mariofritzer/CellDoc/docs/hardware.md

# CellDoc – Hardware

Schaltung, Pinbelegung und Einkaufsliste. Aufbau auf Lochraster oder eigener Platine, **nicht auf dem Steckbrett** (bis 8 A).

| Eckdaten | |
|---|---|
| Last | max. 30 W, max. 8 A (Anschluss A max. 5 A) |
| Packs | bis 6S / 25,2 V, Einzelzellen über Balancer |
| Laden | nur 1S an Anschluss A, 1 A, Li-Ion/LiPo (4,2 V) oder LiFePO4 (3,6 V) |
| Versorgung | 12 V / 3 A |

## Schaltplan

Schaltplan

Erzeugt mit `python3 tools/wiring_gen.py docs/img/schaltplan.svg`. Netzlabel mit gleichem Namen sind verbunden, dicke Linien führen Akku- und Laststrom.

## Aufbau

<picture>
  <source media="(prefers-color-scheme: dark)" srcset="img/aufbau-dark.jpg">
  3D-Ansicht des Aufbaus
</picture>

## Anschlussplan

<picture>
  <source media="(prefers-color-scheme: dark)" srcset="img/anschlussplan-dark.jpg">
  Anschlussplan in der Draufsicht
</picture>

Die Bilder entstehen aus `tools/render/scene.py` (Blender) und `tools/render/compose.py`. Die Anordnung ist ein Vorschlag, die Kabelfarben gelten für die ganze Doku:

| Farbe | Leitung |
|---|---|
| Rot | 12 V |
| Rosa | 5 V |
| Schwarz | Masse |
| Orange (dick) | Akku- und Laststrom |
| Grün (dick) | Ladestrom TP5000 → K1 |
| Blau / Gelb | I²C SDA / SCL |
| Türkis | 1-Wire zu den DS18B20 |
| Lila | Steuersignale (Relais, Lader, Last, Lüfter) |
| Grau | Balancer-Abgriffe |

## Blockschaltbild

<picture>
  <source media="(prefers-color-scheme: dark)" srcset="img/blockschaltbild-dark.png">
  Blockschaltbild von CellDoc
</picture>

Zelle A und Pack B haben getrennte Sicherungen und Strommesser. K2 schaltet die Last auf genau einen Anschluss. Der Lader ist fest nur mit Anschluss A verdrahtet und kann ein Pack daher nie erreichen. Alle Minuspole treffen sich an einem Masse-Sternpunkt.

## Stromversorgung über USB-C

Alle Varianten bekommen ihren Strom über ein **USB-C-PD-Decoy-Modul** („PD/QC/AFC fast charge decoy trigger“). Es handelt mit dem Netzteil eine feste Spannung aus, eingestellt mit drei kleinen Schaltern auf der Rückseite:

| Spannung | S1 | S2 | S3 |
|---|:---:|:---:|:---:|
| 5 V | 0 | 0 | 0 |
| 9 V | 1 | 0 | 0 |
| **12 V** | **1** | **1** | **0** |
| 15 V | 0 | 1 | 0 |
| 20 V | 0 | 1 | 1 |

Die Tabelle steht auch auf der Platine. Es gibt Module mit anderer Belegung, im Zweifel gilt der Aufdruck. Das Modul liefert höchstens 3 A. Vor dem ersten Anschließen die Spannung am Ausgang mit dem Multimeter prüfen.

**CellDoc:** Decoy auf **12 V** (S1 S2 S3 = 1 1 0). Die 12 V versorgen Lüfter und LM358 direkt, der LM2596 macht daraus 5 V für ESP32, TP5000, Relais und Summer. Gebraucht werden nur etwa 10–15 W, die Entladeleistung kommt aus dem Akku. Wichtig: Das Netzteil muss **12 V** können. Viele Laptop-Netzteile liefern nur 5, 9, 15 und 20 V, das steht klein auf dem Netzteil (z. B. „12V⎓2.5A“).

## Leistungspfad

| Von | Nach | Hinweis |
|---|---|---|
| Zelle A + | F1 (7,5 A Flachsicherung) | 18650-Halter, Schraubklemme und Lötpads parallel |
| nach F1 | D1 Kathode, Anode an GND | Verpolschutz: bei falsch gepolter Zelle leitet D1 und F1 löst aus |
| nach F1 | INA226 A IN+ → Shunt → IN− = Knoten A | Shunt 10 mΩ statt des 100 mΩ auf dem Modul |
| Zellpol + (eigene Leitung) | INA226 A VBUS | Fühlerleitung direkt am Pol, damit Kabelverluste nicht in den Innenwiderstand eingehen |
| Knoten A | K2 NC | Ruhezustand: Last an Zelle A |
| TP5000 BAT+ | K1 → Knoten A | Ladestrom läuft durch INA226 A und wird mitgezählt |
| Pack B + (XT60) | F2 (10 A) → D2 → INA226 B → Knoten B | Aufbau wie A, VBUS ebenfalls per Fühlerleitung |
| Knoten B | K2 NO | Nur bei aktivem Packtest |
| K2 COM | Last+ (beide Drains) | Silikonkabel 1,5 mm² |
| Zelle A −, Pack B −, Last-GND | Masse-Sternpunkt | auch ESP32-, INA226- und ADS1115-GND |

## Konstantstromlast

Zwei gleiche Kanäle mit je 15 W. Beide bekommen denselben Sollwert und teilen sich den Strom. Die Firmware regelt den Sollwert mit dem INA226 nach, Bauteiltoleranzen gehen deshalb nicht ins Ergebnis ein.

**Sollwert**

| Bauteil | Anschluss | Verbindung |
|---|---|---|
| MCP4725 | VOUT | 7,5 kΩ → Knoten SOLL → 1 kΩ → GND (0–3,3 V → 0–0,39 V) |
| Q3 BSS138 | D an SOLL, S an GND | Gate an FREIGABE |
| FREIGABE | 10 kΩ nach 3,3 V | ESP32 GPIO 16 zieht LOW = Last frei. Beim Booten oder Absturz ist die Last automatisch aus |

**Je Kanal (zweimal aufbauen)**

| Bauteil | Anschluss | Verbindung |
|---|---|---|
| LM358 (12 V) | IN+ | Knoten SOLL |
| LM358 | IN− | 10 kΩ zum Knoten SENSE, 10 nF von OUT nach IN− |
| LM358 | OUT | 1 kΩ → Gate IRFP250N |
| IRFP250N | Drain | Last+ (K2 COM) |
| IRFP250N | Source | Knoten SENSE → 0,1 Ω / 5 W → GND |
| Q4/Q5 BSS138 | D an Gate, S an GND | Gate an FREIGABE, zieht den MOSFET hart aus |
| Gate | 10 kΩ nach GND | Pull-down |

Beide IRFP250N isoliert (Drain liegt am Gehäuse) auf einen CPU-Kühler mit 4-Pin-Lüfter schrauben. DS18B20 T3 mit Wärmeleitkleber zwischen die MOSFETs.

**Temperaturfühler DS18B20: TO-92 oder wasserdicht, nach Wahl.**
- **TO-92 (empfohlen, vor allem an der Zelle):** reagiert schneller und liegt mit der flachen Seite gut an der Zelle an. Am besten fest in den Zellenhalter kleben (Wärmeleitkleber oder Kaptonband), so dass die eingesetzte Zelle darauf liegt. Beinchen mit Schrumpfschlauch isolieren, der Zellmantel ist Minus.
- **Wasserdicht (Edelstahlhülse mit Kabel):** robuster und fertig verkabelt, aber träger. Gut für den Kühlkörper, an der Zelle weniger.
- Beide Bauformen sind elektrisch gleich (rot = 3,3 V, schwarz/gelb je nach Hersteller = GND/Daten, im Zweifel nachmessen). Die Firmware erkennt beide.

## Lader TP5000

Der CS-Pin wählt die Ladeschlussspannung: **hoch = 4,2 V**, **offen = 3,6 V**, **auf Masse = aus**. Bei Modulen mit 3,6-V-Lötbrücke diese öffnen, damit der ESP32 den Pin steuern kann.

| Modulpin | Verbindung | Zweck |
|---|---|---|
| VIN / GND | 5 V vom Step-Down | Versorgung |
| CS | P-MOSFET AO3401 nach 5 V, über NPN von GPIO 32 | 4,2 V |
| CS | N-MOSFET AO3400 nach GND, Gate an GPIO 33 (10 kΩ Pull-down) | Stopp und Drosselung im Takt |
| CS | beide aus | 3,6 V (LiFePO4), Zustand beim Booten |
| CHRG / STDBY | je 1 kΩ zu GPIO 34 / 35, 10 kΩ Pull-up nach 3,3 V | lädt / voll |
| Rs | 0,1 Ω (Standard) | 1 A Ladestrom |
| TS | an GND | interne Temperaturüberwachung aus, das übernimmt T1 |
| BAT+ | K1 (Schließer) → Knoten A | Lader nur verbunden, wenn K1 anzieht |

## Balancer

Jeder Abgriff des JST-XH-Steckers bekommt einen Teiler 100 kΩ / 10 kΩ (0,1 %). Abgriff 1–4 an ADS1115 Nr. 1 (0x48, ADDR an GND), Abgriff 5–6 an ADS1115 Nr. 2 (0x49, ADDR an VDD). Einmal mit dem Multimeter kalibrieren (Einstellungen → Kalibrierung).

## Temperatur, Lüfter, Summer

| Teil | Verbindung | Hinweis |
|---|---|---|
| 3× DS18B20 | parallel an GPIO 4, 4,7 kΩ nach 3,3 V | T1 Zelle A, T2 Pack, T3 Kühlkörper |
| Lüfter PWM | AO3400 Drain an PWM-Pin, Gate an GPIO 25 | 25 kHz |
| Lüfter TACH | GPIO 39, 10 kΩ nach 3,3 V | Lüfterausfall schaltet die Last ab |
| Summer | aktiver 5-V-Summer über AO3400 an GPIO 17 | Alarm und „fertig“ |

## ESP32-Pinbelegung

| GPIO | Funktion |
|---|---|
| 21 / 22 | I²C SDA / SCL (INA226 ×2, MCP4725, ADS1115 ×2), 4,7 kΩ Pull-ups |
| 4 | 1-Wire DS18B20 ×3 |
| 16 | Last-Freigabe (LOW = frei) |
| 26 | K1 Laderelais |
| 27 | K2 Lastumschaltung A/B |
| 32 | TP5000 CS hoch (4,2 V) |
| 33 | TP5000 CS auf Masse (Stopp) |
| 34 / 35 | TP5000 CHRG / STDBY |
| 25 | Lüfter PWM |
| 39 | Lüfter Drehzahl |
| 17 | Summer |
| 19 / 18 | QR-Scanner TX / RX (optional) |
| 13 / 14 / 23 | Taster ◀ / OK / ▶ (optional, gegen GND) |
| 0 | BOOT-Taste = Not-Aus |

Relaismodule mit Jumper auf **High Level Trigger**, dann bleiben die Relais beim Booten aus.

### Variante mit ESP32-S3

Statt des ESP32 DevKit V1 geht auch ein **ESP32-S3-DevKitC-1 N16R8** (16 MB Flash, 8 MB PSRAM, zwei USB-C-Buchsen). Vorteile: rund 10 MB Speicher für Bestand und Kurven statt 896 KB, mehr Reserve, und die RGB-LED auf dem Board zeigt den Zustand (grün bereit, türkis lädt, orange entlädt, rot blinkend Fehler, blau blinkend Hotspot). Die Pinbelegung ist eine andere, alles Übrige bleibt gleich. Der Webflasher erkennt den S3 selbst; für Updates über die Weboberfläche die Dateien mit `-s3` im Namen nehmen.

- Nicht belegen: IO35–37 (gehören zum PSRAM), IO19/20 (USB), IO0/3/45/46 (Boot-Pins).
- Zum Flashen die USB-C-Buchse mit der Aufschrift **COM** (bzw. UART) nehmen, die zweite (USB) geht auch.

Schaltplan mit ESP32-S3

| Funktion | ESP32 | ESP32-S3 |
|---|---|---|
| I²C SDA / SCL | 21 / 22 | 8 / 9 |
| 1-Wire DS18B20 | 4 | 4 |
| Last-Freigabe | 16 | 5 |
| K1 / K2 | 26 / 27 | 6 / 7 |
| TP5000 CS hoch / Masse | 32 / 33 | 15 / 16 |
| TP5000 CHRG / STDBY | 34 / 35 | 17 / 18 |
| Lüfter PWM / Drehzahl | 25 / 39 | 10 / 11 |
| Summer | 17 | 12 |
| QR-Scanner TX / RX | 19 / 18 | 13 / 14 |
| Taster ◀ / OK / ▶ | 13 / 14 / 23 | 1 / 2 / 42 |
| BOOT = Not-Aus | 0 | 0 |
| RGB-LED auf dem Board | – | 48 |

## Display und Taster (optional)

Wie bei der Mini lässt sich ein **OLED SH1106 1,3"** (I²C, Adresse 0x3C) mit drei Tastern anschließen. Das Display hängt mit an SDA/SCL, die Taster schalten gegen GND (interne Pull-ups, keine Widerstände nötig). Ohne Display läuft alles wie bisher, die Firmware erkennt es beim Start.

| Taste | Wirkung |
|---|---|
| ◀ / ▶ | Seiten: Live, Temperaturen, Balancer, Netzwerk (mit IP-Adresse) |
| OK | Ergebnis oder Fehler bestätigen; auf „Live“ ohne Vorgang: Standardtest an Anschluss A (gescannte oder neue Zelle, 0,5 A, danach Lagerspannung) |
| OK lang | laufenden Vorgang stoppen |

Nach einem Test steht die Zellnummer groß mit Kapazität, Note und Lebenszahl auf dem Display, zum Übertragen aufs Etikett.

## QR-Scanner (optional)

Ein fertiges Scanner-Modul liest die Etiketten direkt am Gerät. Es dekodiert den QR-Code selbst und schickt nur den Text über die serielle Schnittstelle (9600 Baud) an den ESP32.

| Scanner | ESP32 |
|---|---|
| VCC | 3V3 |
| GND | GND |
| TX | IO19 |
| RX | IO18 |

- Empfehlung: **GM861S** (3,3 V Versorgung und Pegel, ca. 15–20 €). Ein **GM65** geht auch, braucht aber 5 V Versorgung. Dann den TX des Scanners über einen Pegelwandler an IO19 legen.
- Den Scanner einmal auf **Induktionsmodus** (Sensing Mode) stellen. Dazu den passenden Einstell-Code aus seinem Handbuch scannen. Dann liest er automatisch, sobald ein Etikett davor gehalten wird.
- Die Firmware erkennt den Scanner von selbst. Unter Einstellungen → Diagnose steht dann „QR-Scanner: ok“.

**Ablauf:** Zelle mit dem Etikett vor den Scanner halten, es piept kurz. Ein langer Ton bedeutet, dass der Code unbekannt ist. Die gescannte Zelle ist danach 10 Minuten lang im Startdialog vorausgewählt. Ist die Seite „Bestand“ offen, öffnet sich die Zelle dort.

## Einkaufsliste

| Menge | Teil | Wofür |
|---|---|---|
| 1 | ESP32 DevKit V1 (WROOM-32, 30 Pin) | Steuerung |
| 2 | INA226-Modul + 2× Shunt 10 mΩ (2512, 1 %) | Strom und Spannung A/B |
| 1 | MCP4725-Modul | Sollwert Last |
| 2 | ADS1115-Modul | Balancer bis 6S |
| 1 | TP5000-Modul (4,2 V / 3,6 V) | Lader 1S |
| 1 | 2-Kanal-Relaismodul 5 V, 10 A, mit High/Low-Jumper | K1, K2 |
| 2 | IRFP250N + isolierende Wärmeleitpads | Last |
| 2 | Widerstand 0,1 Ω / 5 W | Messwiderstand Last |
| 1 | LM358 + Sockel | Regler Last |
| 1 | CPU-Kühler mit 4-Pin-Lüfter 12 V | Kühlung |
| 3 | DS18B20, TO-92 oder wasserdicht (nach Wahl) | T1–T3 |
| – | 3× BSS138, 4× AO3400, 1× AO3401, 1× BC547 | Schalter |
| 1 | Aktiver Summer 5 V | Alarm |
| 1 | Step-Down LM2596 (auf 5,0 V einstellen) | 5-V-Versorgung |
| 1 | USB-C-PD-Decoy-Modul (5/9/12/15/20 V), auf 12 V gestellt | Versorgung |
| 1 | USB-C-Netzteil mit 12 V, ab 20 W | Versorgung |
| 3 | Flachsicherungshalter + Sicherungen 3 / 7,5 / 10 A | F0–F2 |
| 2 | Schottky 15SQ045 | Verpolschutz |
| 1 | 18650-Halter, Schraubklemme ≥ 10 A | Anschluss A |
| 1 | XT60-Buchse, JST-XH 2S–6S oder Balancer-Adapter | Anschluss B |
| – | Widerstände 12× 100 kΩ + 12× 10 kΩ (0,1 %), 7,5 kΩ, 1 kΩ, 10 kΩ, 4,7 kΩ; 10 nF, 100 nF | |
| – | Lochraster, Silikonkabel 1,5 mm² und 0,25 mm² | Aufbau |
| (1) | QR-Scanner GM861S, 3,3 V (optional) | U15 |
| (1) | OLED SH1106 1,3" I²C + 3 Taster (optional) | U16, SW1–3 |

## Aufbau und erste Inbetriebnahme

1. Starkstromwege mit Drahtbrücken oder 1,5-mm²-Kabel, nicht über dünne Lochraster-Leiterbahnen.
2. Masse als Stern, damit Laststrom nicht durch die Messmasse fließt.
3. VBUS-Fühlerleitungen getrennt direkt an den Akkupol.
4. Ohne Akku einschalten, Step-Down auf 5,0 V stellen, flashen, unter Einstellungen → Diagnose alle I²C-Geräte prüfen.
5. Last zuerst mit einer günstigen Zelle bei 0,2 A testen.

> **Sicherheit:** LiPo-Packs nur auf nicht brennbarer Unterlage testen und den Prüfstand bei hohen Strömen nicht unbeaufsichtigt lassen, auch wenn die Firmware abschaltet.
