mariofritzer/CellDoc/docs/img/anschlussplan-dark.jpg

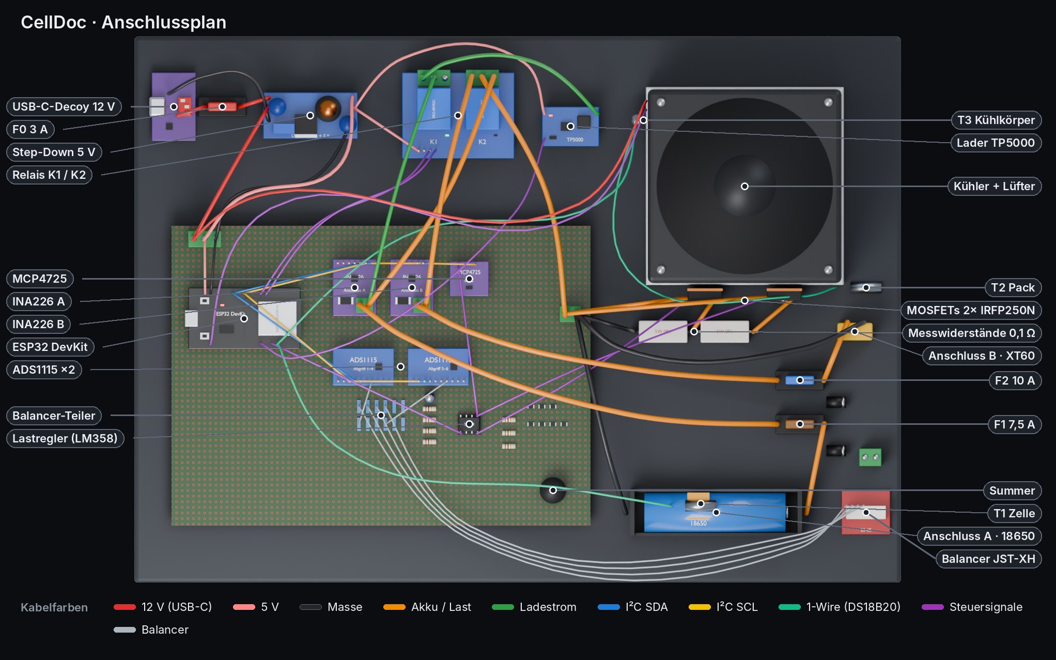
docs/img/anschlussplan-dark.jpg
