mariofritzer/CellDoc/docs/img/blockschaltbild-dark.png

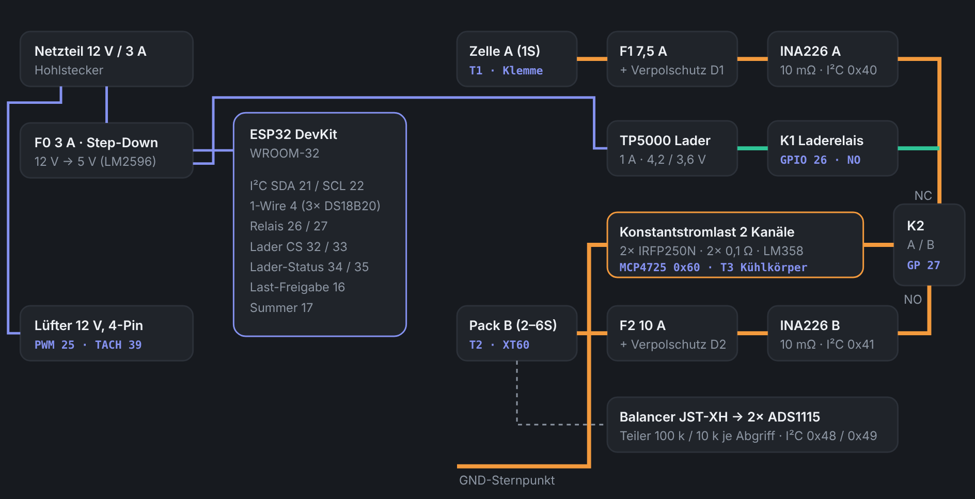
docs/img/blockschaltbild-dark.png
