mariofritzer/CellDoc/docs/img/live-desktop-dark.png

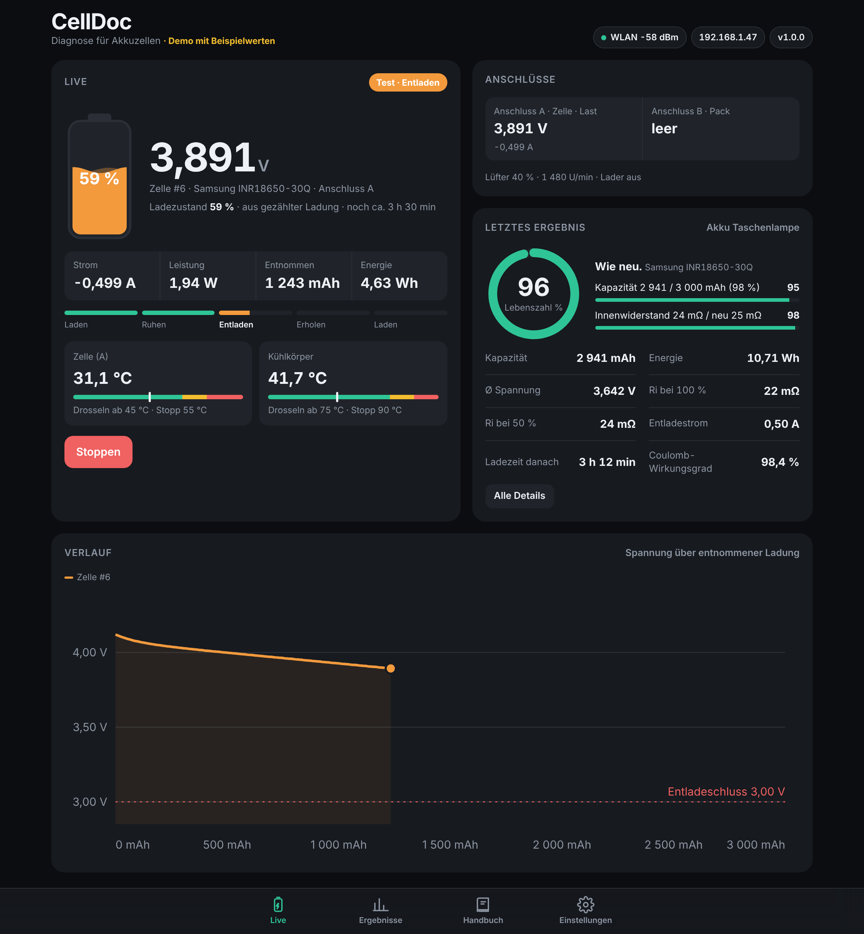
docs/img/live-desktop-dark.png
