mariofritzer/CellDoc/docs/img/aufbau-dark.jpg

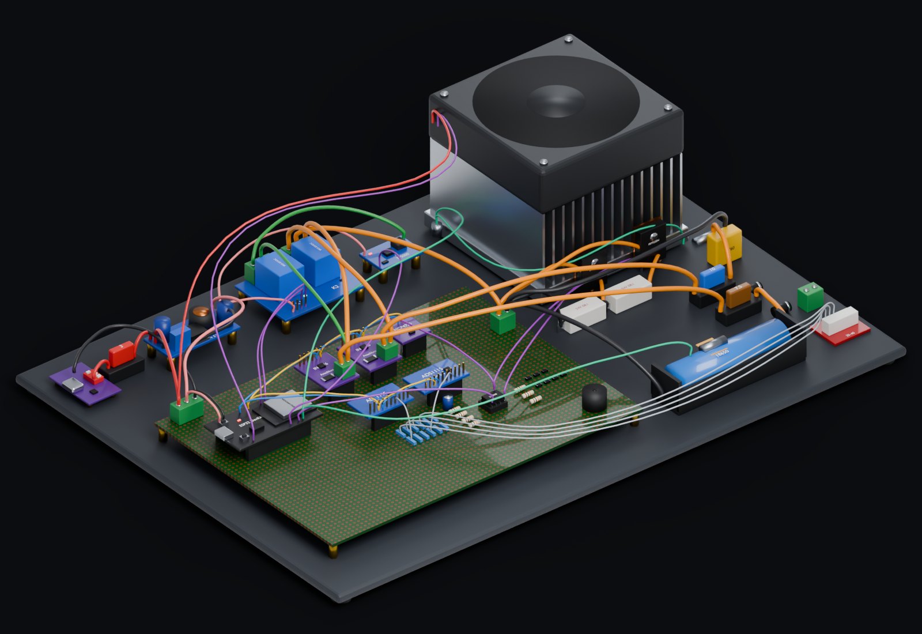
docs/img/aufbau-dark.jpg
