mariofritzer/CellDoc/hardware/nano-pcb/CellDoc-Nano.kicad_pcb

## KiCad design hardware/nano-pcb/CellDoc-Nano.kicad_pcb (2026-10-28)

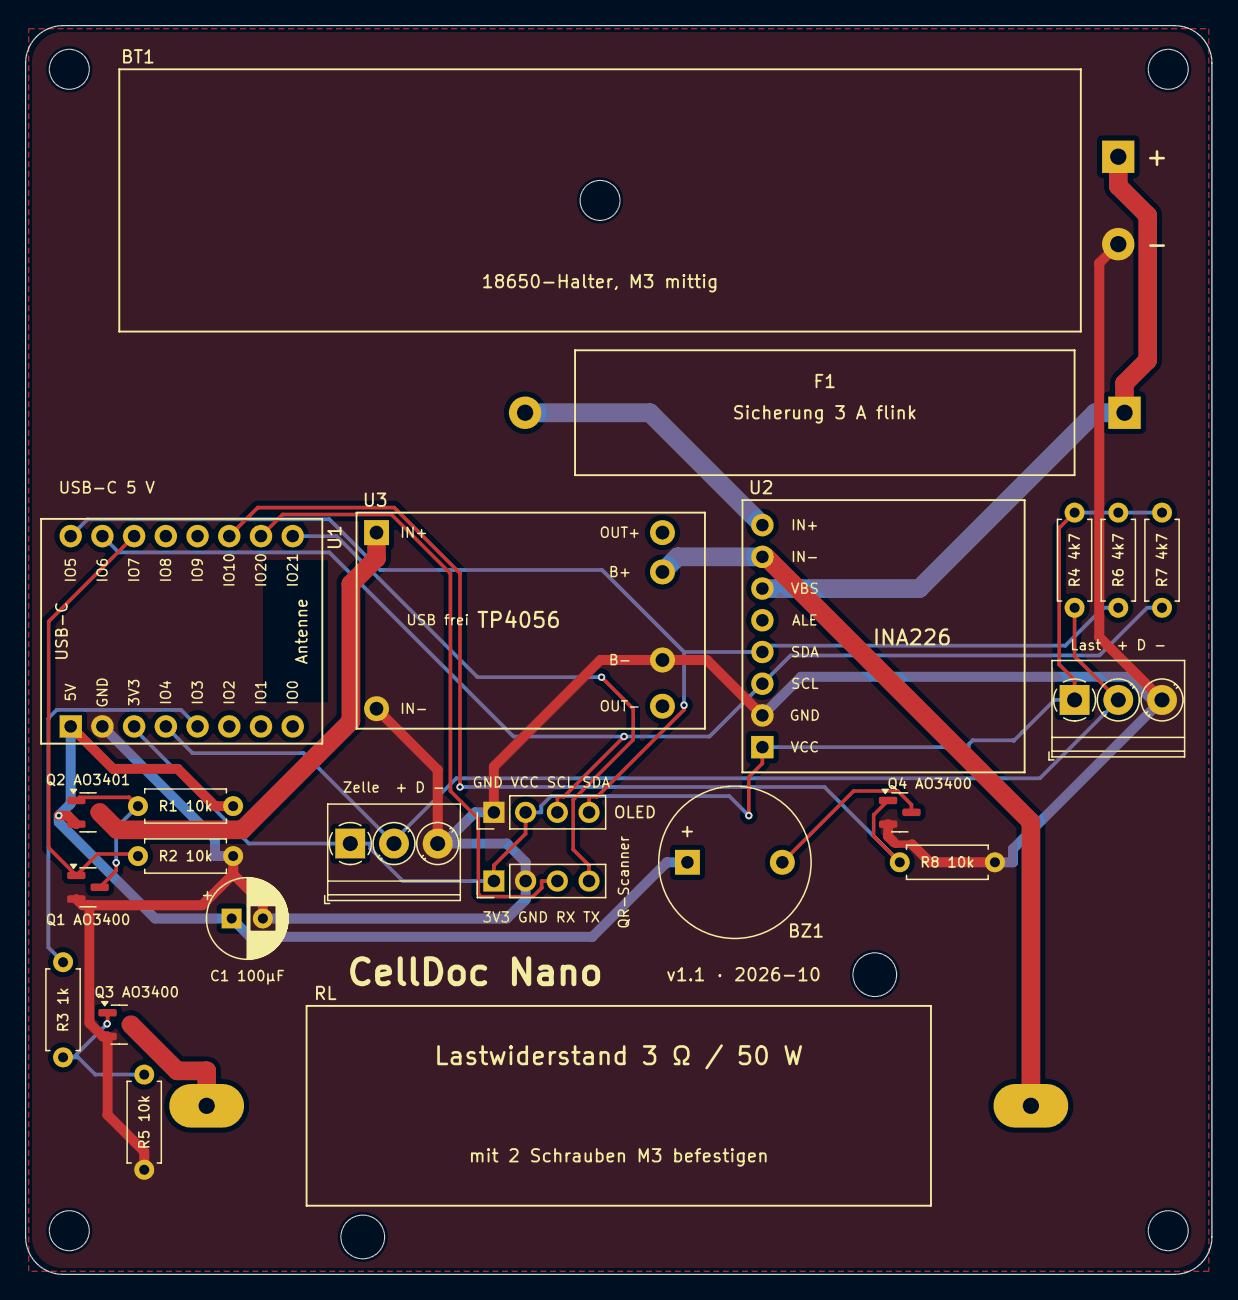
[picture p25: board CellDoc-Nano.kicad_pcb from above]

Board: 2 copper layers, 95.0 x 100.0 mm, 28 parts (0 on the bottom side), 19 nets.

Parts:
BT1: 18650-Halter; 18650_Halter_Kabel
BZ1: Summer 5V; Buzzer_12x9.5RM7.6
C1: 100uF 10V; CP_Radial_D6.3mm_P2.50mm
F1: 3 A flink 5x20; Sicherungshalter_Kabel_5x20
H1, H2, H3, H4: MountingHole_3.2mm_M3
J2: DS18B20 Zelle; TerminalBlock_Phoenix_PT-1,5-3-3.5-H_1x03_P3.50mm_Horizontal
J3: DS18B20 Last opt.; TerminalBlock_Phoenix_PT-1,5-3-3.5-H_1x03_P3.50mm_Horizontal
J4: OLED opt.; PinHeader_1x04_P2.54mm_Vertical
J5: QR GM861S opt.; PinHeader_1x04_P2.54mm_Vertical
Q1, Q3, Q4: AO3400; SOT-23
Q2: AO3401; SOT-23
R1, R2, R5, R8: 10k; R_Axial_DIN0207_L6.3mm_D2.5mm_P7.62mm_Horizontal
R3: 1k; R_Axial_DIN0207_L6.3mm_D2.5mm_P7.62mm_Horizontal
R4: 4k7; R_Axial_DIN0207_L6.3mm_D2.5mm_P7.62mm_Horizontal
R6, R7: 4k7 opt.; R_Axial_DIN0207_L6.3mm_D2.5mm_P7.62mm_Horizontal
RL: 3R 50W; Lastwiderstand_50W_Alu
U1: ESP32-C3 SuperMini; ESP32-C3_SuperMini
U2: INA226 (Shunt R010); INA226_CJMCU-226
U3: TP4056 USB-C; TP4056_USB-C_Protected

Connections:
+3V3: J2.1, J3.1, J4.2, J5.1, R4.1, R6.1, R7.1, U1.3V3, U2.VCC
+5V: BZ1.1, C1.1, Q2.2, R1.2, U1.5V
BAT+: BT1.+, F1.1, U2.VBS
BAT_F: F1.2, U2.IN+
BUZZER: Q4.1, R8.1, U1.10
BZ_N: BZ1.2, Q4.3
CELL: RL.2, U2.IN-, U3.B+
CHG: Q1.1, R2.1, U1.7
GND: BT1.-, C1.2, J2.3, J3.3, J4.1, J5.2, Q1.2, Q3.2, Q4.2, R2.2, R5.2, R8.2, U1.GND, U2.GND, U3.B-, U3.IN-
LOAD_D: Q3.3, RL.1
LOAD_G: Q3.1, R3.2, R5.1
LOAD_PWM: R3.1, U1.3
ONEWIRE: J2.2, J3.2, R4.2, U1.4
Q2_G: Q1.3, Q2.1, R1.1
SCAN_RX: J5.3, U1.20
SCAN_TX: J5.4, U1.21
SCL: J4.3, R7.2, U1.6, U2.SCL
SDA: J4.4, R6.2, U1.5, U2.SDA
TP_IN: Q2.3, U3.IN+
