mariofritzer/CellDoc/src/mini/slot.cpp

#include "slot.h"
#include "cells.h"
#include <time.h>
#include "ocv.h"
#include "settings.h"
#include "soh.h"
#include "storage.h"

using namespace mcfg;

Slot slots[4];
static constexpr uint32_t REST_AFTER_MS = 10UL * 60 * 1000;
static constexpr uint32_t CHARGE_TIMEOUT_MS = 8UL * 3600 * 1000;

const char* phaseId(Phase p) {
  switch (p) {
    case Phase::Idle: return "idle";
    case Phase::PreCharge: return "precharge";
    case Phase::Rest: return "rest";
    case Phase::Discharge: return "discharge";
    case Phase::RestAfter: return "restafter";
    case Phase::Recharge: return "recharge";
    case Phase::Done: return "done";
    case Phase::Error: return "error";
    case Phase::ManualCharge: return "charge";
    case Phase::ManualDischarge: return "manualdischarge";
  }
  return "idle";
}

static bool isCharge(Phase p) { return p == Phase::PreCharge || p == Phase::Recharge || p == Phase::ManualCharge; }
static bool isDischarge(Phase p) { return p == Phase::Discharge || p == Phase::ManualDischarge; }

bool Slot::active() const { return phase_ != Phase::Idle && phase_ != Phase::Done && phase_ != Phase::Error; }

void Slot::begin(uint8_t idx) {
  s_ = idx;
  job_.chem = findChemistry("liion");
}

float Slot::mah() const {
  const SlotMeas& m = hal.m(s_);
  return isDischarge(phase_) ? capMah_ : float(m.chargeAs / 3.6);
}

float Slot::socPercent() const {
  const SlotMeas& m = hal.m(s_);
  if (m.v < 2.0f) return -1;
  if (phase_ == Phase::Recharge && capMah_ > 0) return constrain(float(m.chargeAs / 3.6) / capMah_ * 100, 0.0f, 100.0f);
  if (phase_ == Phase::Discharge && job_.preCharge && job_.nomCapMah > 0)
    return constrain(100 - capMah_ / job_.nomCapMah * 100, 0.0f, 100.0f);
  float v = m.v;
  if (lastRi_ > 0) v += (-m.i) * lastRi_ / 1000;
  return ocv::socFromCellV(*findChemistry("liion"), v);
}

float Slot::thermal(float t, float warn, float stop) const {
  if (isnan(t) || t < warn) return 1;
  float f = 1 - 0.7f * (t - warn) / (stop - warn);
  return f < 0.3f ? 0.3f : f;
}

// ---------------------------------------------------------------------------

String Slot::precheck(const SlotJob& j, bool charge, bool discharge) const {
  if (active()) return "In diesem Schacht läuft bereits ein Vorgang";
  const SlotMeas& m = hal.m(s_);
  if (!m.ok) return "Strommesser von Schacht " + String(s_ + 1) + " antwortet nicht";
  if (m.v < 0.5f) return "In Schacht " + String(s_ + 1) + " steckt keine Zelle";
  if (m.v > MAX_CELL_V) return "Spannung zu hoch (" + String(m.v, 2) + " V). Ist das eine 18650 Li-Ion?";
  if (m.v < 2.5f) return "Zelle ist tiefentladen (" + String(m.v, 2) + " V). Zum Testen ungeeignet, siehe Handbuch";
  if (isnan(m.tCell)) return "Temperaturfühler an Schacht " + String(s_ + 1) + " fehlt";
  if (discharge) {
    if (!hal.dacOk()) return "Last-Sollwertgeber (MCP4728) antwortet nicht";
#ifdef CELLDOC_NANO
    if (settings.sensorSet[SENSOR_SINK] && isnan(hal.tSink())) return "Temperaturfühler am Lastwiderstand fehlt";
#else
    if (isnan(hal.tSink())) return "Temperaturfühler am Kühlkörper fehlt";
#endif
    if (j.currentA < 0.05f || j.currentA > MAX_CURRENT_A)
      return "Entladestrom muss zwischen 0,05 und " + String(MAX_CURRENT_A, 1) + " A liegen";
  }
  (void)charge;
  return "";
}

String Slot::startTest(const SlotJob& jIn) {
  SlotJob j = jIn;
  j.chem = findChemistry("liion");
  String e = precheck(j, true, true);
  if (e.length()) return e;
  e = linkCell(j, true);
  if (e.length()) return e;
  job_ = j;
  sdArmAt_ = 0;
  if (job_.cutoffV <= 0) job_.cutoffV = job_.chem->cutoffV;
  if (job_.cutoffV < 2.7f) job_.cutoffV = 2.7f;
  job_.cycles = constrain(job_.cycles, 1, 10);
  cycleIdx_ = nCyc_ = 0;
  midRe_ = false;
  lastChg_ = 0;
  preMah_ = startOcv_ = restOcv_ = capMah_ = energyWh_ = reMah_ = reWh_ = 0;
  reSec_ = 0;
  riCount_ = riStage_ = 0;
  lastRi_ = 0;
  throttled_ = saturatedSeen_ = false;
  nPts_ = 0;
  ptInterval_ = 10;
  lastPtSec_ = 0;
  tStart_ = tMax_ = hal.m(s_).tCell;
  error_ = "";
  float ref = job_.nomCapMah > 0 ? job_.nomCapMah : 2600;
  riStep_ = max(50.0f, ref * 0.05f);
  startMs_ = millis();
  enter(job_.preCharge ? Phase::PreCharge : Phase::Rest);
  return "";
}

String Slot::startCharge(const SlotJob& jIn) {
  SlotJob j = jIn;
  String e = precheck(j, true, false);
  if (e.length()) return e;
  e = linkCell(j, false);
  if (e.length()) return e;
  job_ = j;
  sdArmAt_ = 0;
  job_.chem = findChemistry("liion");
  error_ = "";
  nPts_ = 0;
  ptInterval_ = 10;
  lastPtSec_ = 0;
  startMs_ = millis();
  enter(Phase::ManualCharge);
  return "";
}

String Slot::startDischarge(const SlotJob& jIn) {
  SlotJob j = jIn;
  String e = precheck(j, false, true);
  if (e.length()) return e;
  e = linkCell(j, false);
  if (e.length()) return e;
  job_ = j;
  sdArmAt_ = 0;
  job_.chem = findChemistry("liion");
  if (job_.cutoffV < 2.7f) job_.cutoffV = job_.chem->cutoffV;
  error_ = "";
  nPts_ = 0;
  ptInterval_ = 10;
  lastPtSec_ = 0;
  riCount_ = riStage_ = 0;
  riStep_ = 1e9;
  startMs_ = millis();
  enter(Phase::ManualDischarge);
  return "";
}

void Slot::stop(const char* reason) {
  if (!active()) return;
  hal.kill(s_);
  error_ = reason ? reason : "Abgebrochen";
  enter(Phase::Error);
}

void Slot::acknowledge() {
  if (phase_ == Phase::Done || phase_ == Phase::Error) enter(Phase::Idle);
}

void Slot::fail(const String& why) {
  hal.kill(s_);
  error_ = why;
  enter(Phase::Error);
  hal.alarm();
}

void Slot::enter(Phase p) {
  phase_ = p;
  phaseMs_ = millis();
  cutoffSince_ = fullSince_ = ovSince_ = ocSince_ = 0;
  loadF_ = chgF_ = 1;
  if (isCharge(p)) {
    hal.setLoad(s_, 0);
    hal.resetCounters(s_);
    hal.setCharger(s_, true);
  } else if (isDischarge(p)) {
    hal.setCharger(s_, false);
    hal.resetCounters(s_);
    nextRiMah_ = 0;
    hal.setLoad(s_, job_.currentA);
  } else {
    hal.kill(s_);
  }
}

// ---------------------------------------------------------------------------

String Slot::linkCell(SlotJob& j, bool create) {
  if (!j.cellNo && !create) return "";
  cells::JobCell c;
  c.no = j.cellNo;
  c.name = j.name;
  c.presetId = j.presetId;
  c.chem = "liion";
  c.nomCapMah = j.nomCapMah;
  c.riNewMilli = j.riNewMilli;
  for (int k = 0; k < NSLOTS; k++)
    if (k != s_ && c.no && slots[k].active() && slots[k].cellNo() == c.no)
      return "Diese Zelle steckt schon in Schacht " + String(k + 1);
  String e = cells::prepare(c);
  if (e.length()) return e;
  j.cellNo = c.no;
  j.cellId = c.id;
  j.name = c.name;
  j.presetId = c.presetId;
  j.nomCapMah = c.nomCapMah;
  j.riNewMilli = c.riNewMilli;
  return "";
}

void Slot::checkSelfDischarge(uint32_t now) {
  if (!sdArmAt_ || phase_ != Phase::Done || int32_t(now - sdArmAt_) < 0) return;
  sdArmAt_ = 0;
  float v = hal.m(s_).v;
  if (!job_.cellNo || v < 2.5f) return;
  cells::setRest(job_.cellNo, v, "test");
  if (sdStartToo_ && v > 3.0f) cells::sdStart(job_.cellNo, v);
}

void Slot::update(uint32_t now) {
  checkSelfDischarge(now);
  if (!active()) return;
  safety(now);
  if (!active()) return;
  logPoint(now);
  const SlotMeas& m = hal.m(s_);
  switch (phase_) {
    case Phase::PreCharge:
    case Phase::Recharge:
    case Phase::ManualCharge:
      handleCharge(now);
      break;
    case Phase::Rest:
      if (now - phaseMs_ >= uint32_t(job_.restMin) * 60000UL) {
        startOcv_ = m.v;
        enter(Phase::Discharge);
      }
      break;
    case Phase::Discharge:
    case Phase::ManualDischarge:
      handleDischarge(now);
      break;
    case Phase::RestAfter:
      if (now - phaseMs_ >= REST_AFTER_MS) {
        restOcv_ = m.v;
        if (nCyc_ < 10) {
          cycCap_[nCyc_] = capMah_;
          cycWh_[nCyc_] = energyWh_;
          cycRi_[nCyc_] = ri50();
          cycChg_[nCyc_] = cycleIdx_ == 0 ? preMah_ : lastChg_;
          nCyc_++;
        }
        if (cycleIdx_ + 1 < job_.cycles) {
          midRe_ = true;
          storageMah_ = 0;
          enter(Phase::Recharge);
        } else if (job_.after == After::None) {
          finish();
        } else {
          storageMah_ = job_.after == After::Storage ? capMah_ * 0.5f : 0;
          enter(Phase::Recharge);
        }
      }
      break;
    default:
      break;
  }
}

void Slot::safety(uint32_t now) {
  const SlotMeas& m = hal.m(s_);
#ifndef CELLDOC_NANO  // Nano: BOOT-Taste ist die Bedientaste (lang = stoppen)
  if (digitalRead(PIN_BOOT) == LOW) { fail("Not-Aus-Taste gedrückt"); return; }
#endif
  if (!m.ok) { fail("Strommesser antwortet nicht mehr"); return; }
  float t = m.tCell;
  if (isnan(t)) { fail("Temperaturfühler an der Zelle ausgefallen"); return; }
  if (isnan(tMax_) || t > tMax_) tMax_ = t;

  float dis = -m.i, tgt = hal.loadTarget(s_);
  bool oc = fabsf(m.i) > MAX_CURRENT_A * 1.3f + 0.2f;
  if (isDischarge(phase_) && dis > max(tgt * OVERCURRENT_FACTOR, tgt + 0.3f)) oc = true;
  if (isCharge(phase_) && m.i > CHG_MAX_A * 1.3f) oc = true;
  if (oc) {
    if (!ocSince_) ocSince_ = now;
    if (now - ocSince_ > OVERCURRENT_MS) { fail("Überstrom " + String(fabsf(m.i), 2) + " A"); return; }
  } else {
    ocSince_ = 0;
  }

  if (isCharge(phase_)) {
    if (t >= settings.chargeStopC) { fail("Zelle zu heiß beim Laden (" + String(t, 1) + " °C)"); return; }
    chgF_ = thermal(t, settings.chargeWarnC, settings.chargeStopC);
    hal.setChargerDuty(s_, chgF_);
    if (chgF_ < 0.99f) throttled_ = true;
    if (m.v > 4.25f) {
      if (!ovSince_) ovSince_ = now;
      if (now - ovSince_ > 2000) { fail("Überspannung beim Laden (" + String(m.v, 3) + " V)"); return; }
    } else {
      ovSince_ = 0;
    }
  } else if (isDischarge(phase_)) {
    if (t >= settings.dischargeStopC) { fail("Zelle zu heiß beim Entladen (" + String(t, 1) + " °C)"); return; }
    float ts = hal.tSink();
    float sinkStop = min(settings.sinkStopC, SINK_STOP_C);
#ifdef CELLDOC_NANO
    // Fühler am Lastwiderstand ist optional
    if (isnan(ts) && settings.sensorSet[SENSOR_SINK]) { fail("Temperaturfühler am Lastwiderstand ausgefallen"); return; }
    if (!isnan(ts) && ts >= sinkStop) { fail("Lastwiderstand zu heiß (" + String(ts, 1) + " °C)"); return; }
#else
    if (isnan(ts)) { fail("Temperaturfühler am Kühlkörper ausgefallen"); return; }
    if (ts >= sinkStop) { fail("Kühlkörper zu heiß (" + String(ts, 1) + " °C)"); return; }
#endif
    loadF_ = min(thermal(t, settings.dischargeWarnC, settings.dischargeStopC), thermal(ts, settings.sinkWarnC, sinkStop));
    if (loadF_ < 0.99f) throttled_ = true;
  }
}

void Slot::handleCharge(uint32_t now) {
  const SlotMeas& m = hal.m(s_);
  if (hal.chargerWaiting(s_)) {
    // wartet auf einen freien Ladeplatz: Zeitüberwachung beginnt erst beim Laden
    phaseMs_ = now;
    fullSince_ = 0;
    hal.resetCounters(s_);
    return;
  }
  uint32_t t = now - phaseMs_;
  float mah = float(m.chargeAs / 3.6);
  if (t > CHARGE_TIMEOUT_MS) { fail("Laden dauert zu lange (über 8 h)"); return; }
  if (t > 120000 && mah < 5 && m.v < 4.1f) { fail("Lader liefert keinen Strom"); return; }
  bool full = false;
  // TP4056 beendet bei ca. 1/10 des Ladestroms
  if (t > 60000 && m.v >= 4.15f && m.i < 0.12f && chgF_ > 0.99f) {
    if (!fullSince_) fullSince_ = now;
    if (now - fullSince_ > 30000) full = true;
  } else {
    fullSince_ = 0;
  }
  if (phase_ == Phase::Recharge && storageMah_ > 0 && mah >= storageMah_) full = true;
  if (!full) return;
  hal.setCharger(s_, false);
  if (phase_ == Phase::PreCharge) {
    preMah_ = mah;
    enter(Phase::Rest);
  } else if (phase_ == Phase::Recharge && midRe_) {
    midRe_ = false;
    lastChg_ = mah;
    cycleIdx_++;
    riCount_ = 0;
    enter(Phase::Rest);
  } else if (phase_ == Phase::Recharge) {
    reMah_ = mah;
    reWh_ = float(m.energyWs / 3600.0);
    reSec_ = t / 1000;
    finish();
  } else {
    enter(Phase::Done);
    hal.beep(500);
  }
}

void Slot::handleDischarge(uint32_t now) {
  const SlotMeas& m = hal.m(s_);
  capMah_ = float(-m.chargeAs / 3.6);
  energyWh_ = float(-m.energyWs / 3600.0);
  if (hal.loadSaturated(s_)) saturatedSeen_ = true;
  if (riStage_) { handleRi(now); return; }
  float target = job_.currentA * loadF_;
  if (fabsf(target - hal.loadTarget(s_)) > 0.01f) hal.setLoad(s_, target);
  if (m.v <= job_.cutoffV) {
    if (!cutoffSince_) cutoffSince_ = now;
  } else if (m.v > job_.cutoffV + 0.02f) {
    cutoffSince_ = 0;
  }
  if (cutoffSince_ && now - cutoffSince_ > 2000) {
    hal.setLoad(s_, 0);
    logPoint(now, true);
    if (phase_ == Phase::ManualDischarge) {
      enter(Phase::Done);
      hal.beep(500);
    } else {
      enter(Phase::RestAfter);
    }
    return;
  }
  if (capMah_ >= nextRiMah_ && now - phaseMs_ > 5000 && m.v > job_.cutoffV + 0.15f) {
    nextRiMah_ = capMah_ + riStep_;
    startRi(now);
  }
}

void Slot::startRi(uint32_t now) {
  if (riCount_ >= MAX_RI) return;
  riBase_ = hal.loadTarget(s_);
#ifdef CELLDOC_NANO
  // Nano: Last kurz ganz abschalten (Sprung nach unten)
  riDelta_ = -riBase_;
  if (riBase_ < 0.2f) return;
#else
  riDelta_ = min(1.0f, MAX_CURRENT_A - riBase_);
  if (riDelta_ < 0.2f) return;
#endif
  riStage_ = 1;
  riT0_ = now;
  riV1_ = riI1_ = 0;
  riN1_ = 0;
  riSeq_ = hal.m(s_).seq;
}

void Slot::handleRi(uint32_t now) {
  const SlotMeas& m = hal.m(s_);
  if (riStage_ == 1) {
    if (m.seq != riSeq_) {
      riSeq_ = m.seq;
      riV1_ += m.v;
      riI1_ += -m.i;
      riN1_++;
    }
    if (now - riT0_ >= 500 && riN1_ >= 5) {
      hal.setLoad(s_, riBase_ + riDelta_);
      riStage_ = 2;
      riT0_ = now;
    }
    return;
  }
  if (m.v < job_.cutoffV - 0.3f) {
    hal.setLoad(s_, riBase_);
    riStage_ = 0;
    return;
  }
  if (now - riT0_ < 1000) return;
  float v1 = riV1_ / riN1_, i1 = riI1_ / riN1_, v2 = m.v, i2 = -m.i;
  hal.setLoad(s_, riBase_);
  riStage_ = 0;
  if (fabsf(i2 - i1) < 0.15f) return;
  riQ_[riCount_] = capMah_;
  riR_[riCount_] = (v1 - v2) / (i2 - i1) * 1000;
  lastRi_ = riR_[riCount_];
  riCount_++;
}

void Slot::logPoint(uint32_t now, bool force) {
  uint32_t sec = (now - startMs_) / 1000;
  if (!force && nPts_ && sec - lastPtSec_ < ptInterval_) return;
  if (nPts_ >= MAX_POINTS) {
    int j = 0;
    for (int k = 0; k < nPts_; k += 2) pts_[j++] = pts_[k];
    nPts_ = j;
    ptInterval_ *= 2;
  }
  const SlotMeas& m = hal.m(s_);
  pts_[nPts_++] = {sec, m.v, m.i, float(m.chargeAs / 3.6), m.tCell};
  lastPtSec_ = sec;
}

float Slot::ri50() const {
  float r = riCount_ ? riR_[0] : 0, best = 1e9;
  for (int k = 0; k < riCount_; k++) {
    float d = fabsf(riQ_[k] - capMah_ / 2);
    if (d < best) { best = d; r = riR_[k]; }
  }
  return r;
}

void Slot::finish() {
  hal.kill(s_);
  float ri100 = riCount_ ? riR_[0] : 0, ri50 = 0, best = 1e9;
  for (int k = 0; k < riCount_; k++) {
    float d = fabsf(riQ_[k] - capMah_ / 2);
    if (d < best) { best = d; ri50 = riR_[k]; }
  }
  SohResult r = soh::compute({job_.chem, 1, capMah_, ri50 > 0 ? ri50 : ri100, job_.nomCapMah, job_.riNewMilli});
  uint32_t id = settings.nextResultId++;
  settings.save();
  JsonDocument d;
  d["id"] = id;
  d["name"] = job_.name;
  d["cell"] = job_.cellNo;
  d["cellId"] = job_.cellId;
  time_t now = time(nullptr);
  d["time"] = now > 1700000000 ? uint32_t(now) : 0;
  d["port"] = "S" + String(s_ + 1);
  d["slot"] = s_ + 1;
  d["chem"] = job_.chem->id;
  d["preset"] = job_.presetId;
  const CellPreset* pr = findPreset(job_.presetId.c_str());
  d["presetName"] = pr ? pr->name : "";
  d["cells"] = 1;
  d["nomCapMah"] = job_.nomCapMah;
  d["riNew"] = job_.riNewMilli;
  d["currentA"] = job_.currentA;
  d["cutoffV"] = job_.cutoffV;
  d["capMah"] = roundf(capMah_);
  d["energyWh"] = roundf(energyWh_ * 100) / 100;
  d["avgV"] = capMah_ > 1 ? roundf(energyWh_ / (capMah_ / 1000) * 1000) / 1000 : 0;
  d["ri100"] = roundf(ri100 * 10) / 10;
  d["ri50"] = roundf(ri50 * 10) / 10;
  JsonArray rl = d["riCurve"].to<JsonArray>();
  for (int k = 0; k < riCount_; k++) {
    JsonArray p = rl.add<JsonArray>();
    p.add(roundf(riQ_[k]));
    p.add(roundf(riR_[k] * 10) / 10);
  }
  d["startOcv"] = startOcv_;
  d["restOcv"] = restOcv_;
  d["preChargeMah"] = roundf(preMah_);
  d["rechargeMah"] = roundf(reMah_);
  d["rechargeWh"] = roundf(reWh_ * 100) / 100;
  d["rechargeSec"] = reSec_;
  if (job_.after == After::Full && reMah_ > 0) {
    d["coulombEff"] = roundf(capMah_ / reMah_ * 1000) / 10;
    d["energyEff"] = reWh_ > 0 ? roundf(energyWh_ / reWh_ * 1000) / 10 : 0;
  }
  d["after"] = job_.after == After::Full ? "full" : job_.after == After::Storage ? "storage" : "none";
  d["tempMax"] = isnan(tMax_) ? 0 : roundf(tMax_ * 10) / 10;
  d["tempRise"] = (isnan(tMax_) || isnan(tStart_)) ? 0 : roundf((tMax_ - tStart_) * 10) / 10;
  d["throttled"] = throttled_;
  d["saturated"] = saturatedSeen_;
  d["durationSec"] = (millis() - startMs_) / 1000;
  if (nCyc_ > 1) {
    JsonArray ca = d["cycles"].to<JsonArray>();
    for (int k = 0; k < nCyc_; k++) {
      JsonObject c = ca.add<JsonObject>();
      c["cap"] = roundf(cycCap_[k]);
      c["wh"] = roundf(cycWh_[k] * 100) / 100;
      c["ri"] = roundf(cycRi_[k] * 10) / 10;
      c["chg"] = roundf(cycChg_[k]);
    }
  }
  JsonObject so = d["soh"].to<JsonObject>();
  so["score"] = r.score;
  so["low"] = r.low;
  so["high"] = r.high;
  so["estimated"] = r.estimated;
  so["capScore"] = r.capScore;
  so["riScore"] = r.riScore;
  so["capRatio"] = roundf(r.capRatio * 1000) / 10;
  so["refCapMah"] = r.refCapMah;
  so["verdict"] = soh::verdict(r.score);
  float base = cells::firstCapacity(job_.cellNo);
  if (base > 0) d["baselineCapMah"] = base;
  storage::saveResult(id, d, pts_, nPts_);
  cells::addResult(job_.cellNo, d);
  lastResultId_ = id;
  lastScore_ = r.score;
  lastCap_ = capMah_;
  lastCellId_ = job_.cellId;
  sdArmAt_ = millis() + 3600000UL;
  sdStartToo_ = job_.after == After::Full;
  enter(Phase::Done);
  hal.beep(800);
}

// ---------------------------------------------------------------------------

void Slot::stateJson(JsonObject o) const {
  const SlotMeas& m = hal.m(s_);
  uint32_t now = millis();
  o["slot"] = s_ + 1;
  o["phase"] = phaseId(phase_);
  o["error"] = error_;
  o["lastResult"] = lastResultId_;
  if (phase_ != Phase::Idle) {
    JsonObject j = o["job"].to<JsonObject>();
    j["port"] = "S" + String(s_ + 1);
    j["name"] = job_.name;
    j["cell"] = job_.cellNo;
    j["cellId"] = job_.cellId;
    j["chem"] = "liion";
    j["preset"] = job_.presetId;
    j["cells"] = 1;
    j["currentA"] = job_.currentA;
    j["nomCapMah"] = job_.nomCapMah;
    j["cutoffV"] = job_.cutoffV;
    j["preCharge"] = job_.preCharge;
    j["restMin"] = job_.restMin;
    j["after"] = job_.after == After::Full ? "full" : job_.after == After::Storage ? "storage" : "none";
    j["cycles"] = job_.cycles;
    o["cycle"] = cycleIdx_ + 1;
    o["elapsed"] = (now - startMs_) / 1000;
    o["phaseElapsed"] = (now - phaseMs_) / 1000;
    if (phase_ == Phase::Rest) o["phaseTotal"] = uint32_t(job_.restMin) * 60;
    if (phase_ == Phase::RestAfter) o["phaseTotal"] = REST_AFTER_MS / 1000;
    o["mah"] = mah();
    o["wh"] = isDischarge(phase_) ? energyWh_ : float(m.energyWs / 3600.0);
    o["capMah"] = capMah_;
    o["riLast"] = lastRi_;
    o["riPulse"] = riStage_ != 0;
    o["throttle"] = isCharge(phase_) ? chgF_ : loadF_;
    o["throttled"] = throttled_;
    o["saturated"] = hal.loadSaturated(s_);
    if (phase_ == Phase::Discharge && job_.nomCapMah > 0 && job_.currentA > 0) {
      float rest = job_.nomCapMah - capMah_;
      if (rest > 0) o["eta"] = uint32_t(rest / (job_.currentA * 1000) * 3600);
    }
  }
  o["soc"] = roundf(socPercent());
  if (lastScore_ >= 0) {
    JsonObject l = o["last"].to<JsonObject>();
    l["cellId"] = lastCellId_;
    l["cap"] = roundf(lastCap_);
    l["score"] = lastScore_;
    l["grade"] = String(soh::grade(lastScore_));
  }
  JsonArray ports = o["ports"].to<JsonArray>();
  JsonObject p = ports.add<JsonObject>();
  p["ok"] = m.ok;
  p["v"] = roundf(m.v * 1000) / 1000;
  p["i"] = roundf(m.i * 1000) / 1000;
  p["p"] = roundf(m.p * 100) / 100;
  JsonObject p2 = ports.add<JsonObject>();
  p2["ok"] = false;
  p2["v"] = 0;
  p2["i"] = 0;
  p2["p"] = 0;
  o["loadPort"] = "A";
  o["loadTarget"] = hal.loadTarget(s_);
  JsonObject t = o["temps"].to<JsonObject>();
  if (!isnan(m.tCell)) t["cell"] = m.tCell;
  if (!isnan(hal.tSink())) t["sink"] = hal.tSink();
  JsonObject ch = o["charger"].to<JsonObject>();
  ch["mode"] = hal.charger(s_) ? "4.2" : "off";
  if (hal.chargerWaiting(s_)) ch["waiting"] = true;
  ch["charging"] = hal.charger(s_) && m.i > 0.05f;
  ch["full"] = false;
}

void Slot::curveJson(JsonArray a) const {
  for (int k = 0; k < nPts_; k++) {
    JsonArray p = a.add<JsonArray>();
    p.add(pts_[k].t);
    p.add(roundf(pts_[k].v * 1000) / 1000);
    p.add(roundf(pts_[k].i * 1000) / 1000);
    p.add(roundf(pts_[k].qmAh));
    p.add(isnan(pts_[k].temp) ? 0 : roundf(pts_[k].temp * 10) / 10);
  }
}
