mariofritzer/CellDoc/(commit log)

2026-10-25 CellDoc: Firmware, Weboberfläche mit Handbuch, Hardware-Doku und Build
    - ESP32-Firmware: INA226/ADS1115/MCP4725-Treiber, Konstantstromlast mit
    Regelung, TP5000-Lader (4,2/3,6 V), Balancer bis 6S, DS18B20, Lüfter
    - Kapazitätstest mit Ri-Pulsen, Lebenszahl inkl. Schätzmodus, Ergebnisse
    im LittleFS, Sicherheitsüberwachung mit Drosselung und Abschaltung
    - Weboberfläche (Live, Ergebnisse, Handbuch, Einstellungen) mit Demo-Modus
    - GitHub Actions: Tests, Build, Releases, Demo auf GitHub Pages
    Claude-Session: https://claude.ai/code/session_0174AR2gjQsi8o2Mnoy7uE2F
2026-10-25 Schaltplan im Liquid-Harvest-Stil, 3D-Ansicht und Anschlussplan
    - tools/wiring_gen.py erzeugt docs/img/schaltplan.svg (Blattrahmen,
    Abschnitte, alle Bauteile, Stückliste, Hinweise, Schriftfeld)
    - tools/render: Blender-Szene des Aufbaus und beschrifteter Anschlussplan
    - README und docs/hardware.md mit den neuen Bildern
    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
2026-10-25 Schaltplan: Balancer-Teiler einzeln gezeichnet
    Die sechs Teiler 100 kΩ / 10 kΩ sind jetzt als R33–R44 ausgeführt und
    über die Netze TAP1–TAP6 mit den ADS1115 verbunden. Vorher lag die
    B4-Leitung optisch auf der B3-Leitung.
    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
2026-10-25 Schaltplan: keine Beschriftung mehr auf Linien
    - DS18B20-Block neu angeordnet, Referenzen in die Gehäuse
    - Netzlabel SENSE_A/B und FAN_TACH frei von Pinnummern
    - tools/check_svg.py prüft Text gegen Linien, Kästen und anderen Text
    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
2026-10-25 CellDoc Mini: Schaltpläne für 1, 2 und 4 Schächte
    - tools/schematic.py: gemeinsame Symbolbibliothek
    - tools/wiring_gen_mini.py erzeugt docs/img/schaltplan-mini-{1,2,4}.svg
    - je Schacht INA226, TP4056 mit MOSFET-Schalter und Konstantstromlast,
    gemeinsamer MCP4728, optionales OLED mit drei Tastern
    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
2026-10-25 CellDoc Mini: Firmware für 1, 2 und 4 Schächte
    - Build-Varianten mini1, mini2, mini4 (gleiche Lebenszahl, Speicher, Web)
    - Web-API aufgeteilt in gemeinsamen Teil und Gerät (web_full / mini)
    - Schacht-Tester mit Laden, Konstantstrom-Entladung, Ri-Pulsen, Schutz
    - MCP4728-Treiber, optionales SH1106-OLED mit drei Tastern
    - GitHub Actions baut alle vier Varianten und meldet Compilerfehler
    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
2026-10-25 CellDoc Mini: Weboberfläche mit Schächten, Demo und Doku
    - Schachtübersicht, Live/Start/Stopp/Kalibrierung je Schacht
    - Demo-Modus ?mini=1|2|4
    - docs/mini.md mit Schaltplänen, Stücklisten, Bedienung
    - README und Handbuch ergänzt
    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
2026-10-25 Webflasher auf GitHub Pages (/flash/) für CellDoc und Mini 1/2/4
    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
2026-10-25 Zellenbestand mit Etiketten, Selbstentladung, Pack, MQTT und Datensicherung
    - feste Zellnummer (CD-0042) je Zelle, Tests verknüpft, Vergleich mit dem ersten Test
    - Bestand mit Suche nach Nummer, Name, Ort, Notiz; Filter, Noten A-D
    - Etiketten als 203-dpi-Bild mit QR-Code für Supvan E16 u. a., CSV für die App
    - Selbstentladungstest, automatisch eine Stunde nach dem Vollladen gestartet
    - Pack-Zusammenstellung mit gleich starken Parallelgruppen
    - MQTT mit Home-Assistant-Erkennung, Datensicherung und CSV-Export
    - OLED der Mini zeigt Nummer und Note nach dem Test
    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
2026-10-25 WIP QR-Scanner: Firmware und Schaltpläne
    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
2026-10-25 QR-Code scannen: Handykamera und Scanner-Modul am Gerät
    - Weboberfläche: Scannen per Foto (geht über HTTP) oder live (HTTPS), jsQR eingebettet
    - Scannen im Bestand öffnet die Zelle, im Startdialog wird sie ausgewählt
    - optionaler UART-Scanner (GM861S) an IO19/IO18 für CellDoc und Mini
    - Mini ordnet die gescannte Zelle dem Schacht zu, in den sie gesteckt wird; OK startet den Test
    - Schaltpläne, Stücklisten, Doku und Handbuch ergänzt
    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
2026-10-25 Zyklentest, Kurvenvergleich, Pack-Bauplan, Spannungscheck, gemeinsamer Bestand
    - Zyklentest: bis zu 10 Lade-/Entladezyklen, Kapazität, Energie und Ri je Zyklus
    - Kurven mehrerer Tests übereinander (mAh oder % der Kapazität)
    - druckbarer Bauplan mit Polung, Nickelbändern und Balancer-Abgriffen
    - Ruhespannung eine Stunde nach dem Test, Vergleich beim Wiedereinstecken/Scannen
    - mehrere Geräte im WLAN teilen Bestand und Nummern (Abgleich per HTTP, mDNS-Suche,
    Grabsteine fürs Löschen, Hinweis bei doppelt vergebener Nummer)
    - Gerätename einstellbar, Verlauf der Zelle mit Gerät
    Claude-Session: https://claude.ai/code/session_0174AR2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
2026-10-26 Schaltplan Mini: Opamp als Chip mit Pinbelegung, INA226-Adressen 0x40/41/44/45
    - U3 (LM324 bzw. LM358) zusätzlich als DIP-Gehäuse von oben mit allen Pins und Verbindungen
    - INA226 der Schächte 3 und 4 auf 0x44/0x45: geht mit den A0/A1-Lötbrücken (GND/VCC) aller gängigen Module
    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
2026-10-26 Versorgung über USB-C mit PD-Decoy, Ladeplätze der Mini begrenzbar
    - alle Schaltpläne: USB-C-PD-Decoy statt DC-Buchse (CellDoc 12 V, Mini 1/2 5 V, Mini 4 12 V + Mini560)
    - Schalterstellung S1–S3 im Schaltplan und in der Doku
    - Mini: Einstellung „Gleichzeitig laden“, weitere Schächte warten auf einen freien Ladeplatz
    - Mini 4 lädt ab Werk höchstens 3 Schächte gleichzeitig
    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
2026-10-26 Temperaturfühler: Aussetzer, 85-°C-Einschaltwert und Sprünge überbrücken
    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
2026-10-26 3D-Ansicht und Anschlussplan mit USB-C-Decoy
    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
2026-10-26 Speicher: 896 KB für Bestand und Ergebnisse statt 192 KB
    - eigene Partitionstabelle für 4 MB Flash: 2 × 1,5 MB App (Updates per Web), 896 KB Daten
    - bei vollem Speicher zuerst alte Kurven löschen, Messwerte und Zellenbestand bleiben
    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
    [partitions.csv]
2026-10-26 WIP ESP32-S3: Pins, Umgebungen, Partitionen, CI
    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
    [partitions_s3.csv]
2026-10-26 ESP32-S3 (DevKitC-1 N16R8) als zweite Board-Variante für alle Geräte
    - eigene Pinbelegung, 16-MB-Partitionen (2 × 3 MB App, ~10 MB Daten), PSRAM
    - Schaltpläne schaltplan-s3.svg und schaltplan-mini-<n>-s3.svg aus denselben Generatoren
    - RGB-LED auf dem Board zeigt den Zustand
    - CI baut 8 Varianten; der Webflasher wählt ESP32 oder ESP32-S3 automatisch
    - Doku mit Pin-Gegenüberstellung
    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
2026-10-26 Display und Taster (optional) auch am großen CellDoc
    - OLED SH1106 mit vier Seiten: Live, Temperaturen, Balancer, Netzwerk
    - Taster ◀ / OK / ▶ (ESP32: IO13/14/23, S3: IO1/2/42), OK startet einen Standardtest an A, lang = Stopp
    - nach dem Test Zellnummer, Kapazität, Note und Lebenszahl groß
    - Schaltpläne (ESP32 und S3), Stückliste, Doku, Handbuch
    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
2026-10-27 WIP CellDoc Nano: Firmware (ESP32-C3, PWM-Last, ein Schacht)
    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
2026-10-27 CellDoc Nano: Schaltplan, Weboberfläche, Webflasher, Doku
    - ESP32-C3 SuperMini, INA226 (10 mΩ), TP4056 über AO3401 schaltbar,
    Lastwiderstand 3 Ω per 10-kHz-PWM auf Konstantstrom geregelt
    - Ri-Messung über kurzes Abschalten der Last
    - BOOT-Taste als Bedientaste, Board-LED als Statusanzeige
    - Demo unter ?nano=1, Webflasher-Eintrag, docs/nano.md
    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
2026-10-28 CellDoc Nano: Platine (KiCad, Gerber)
    - 95 x 76 mm, zweilagig, GND-Flaechen beidseitig
    - Module aufgesteckt: ESP32-C3 SuperMini, INA226 (CJMCU-226), TP4056 USB-C mit Schutz
    - 18650-Halter Keystone 1042, Sicherung 5x20, Klemmen fuer Last und DS18B20
    - Generator tools/pcb (pcbnew-Python + Freerouting), DRC ohne Fehler
    Claude-Session: https://claude.ai/code/session_01WtJ5FLprrJxW2qKdxjRQsn
    [CellDoc-Nano-B_Cu.gbl, CellDoc-Nano-B_Mask.gbs, CellDoc-Nano-B_Paste.gbp, CellDoc-Nano-B_Silkscreen.gbo, CellDoc-Nano-Edge_Cuts.gm1, CellDoc-Nano-F_Cu.gtl, CellDoc-Nano-F_Mask.gts, CellDoc-Nano-F_Paste.gtp]
2026-10-28 Nano-Platine: GND-Pins der Stecker voll an Flaeche, R1 versetzt
    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
    [CellDoc-Nano-B_Cu.gbl, CellDoc-Nano-B_Mask.gbs, CellDoc-Nano-B_Paste.gbp, CellDoc-Nano-B_Silkscreen.gbo, CellDoc-Nano-Edge_Cuts.gm1, CellDoc-Nano-F_Cu.gtl, CellDoc-Nano-F_Mask.gts, CellDoc-Nano-F_Paste.gtp]
2026-10-28 Nano-Platine neu erzeugt (Thermals, R1)
    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
    [CellDoc-Nano-B_Cu.gbl, CellDoc-Nano-B_Mask.gbs, CellDoc-Nano-B_Paste.gbp, CellDoc-Nano-B_Silkscreen.gbo, CellDoc-Nano-Edge_Cuts.gm1, CellDoc-Nano-F_Cu.gtl, CellDoc-Nano-F_Mask.gts, CellDoc-Nano-F_Paste.gtp]
2026-10-28 Nano-Platine: alle GND-Pads voll an Flaeche
    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
    [CellDoc-Nano-B_Cu.gbl, CellDoc-Nano-B_Mask.gbs, CellDoc-Nano-B_Paste.gbp, CellDoc-Nano-B_Silkscreen.gbo, CellDoc-Nano-Edge_Cuts.gm1, CellDoc-Nano-F_Cu.gtl, CellDoc-Nano-F_Mask.gts, CellDoc-Nano-F_Paste.gtp]
2026-10-28 Nano-Platine v1.1: Halter mit Kabeln, Sicherungshalter und 50-W-Lastwiderstand direkt auf der Platine
    - 95 x 100 mm, Lastwiderstand mit 2 x M3 verschraubt, Loetfahnen auf Loetaugen
    - 18650-Halter mit M3 mittig, Kabel in Loetaugen
    - Kabel-Sicherungshalter 5x20 auf Loetaugen
    - C3 mit USB-C an der linken Kante, Summer bleibt bestueckbar
    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
    [CellDoc-Nano-B_Cu.gbl, CellDoc-Nano-B_Mask.gbs, CellDoc-Nano-B_Paste.gbp, CellDoc-Nano-B_Silkscreen.gbo, CellDoc-Nano-Edge_Cuts.gm1, CellDoc-Nano-F_Cu.gtl, CellDoc-Nano-F_Mask.gts, CellDoc-Nano-F_Paste.gtp]
2026-10-28 Nano-Platine: Beschriftung USB-C eingerueckt
    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
    [CellDoc-Nano-B_Cu.gbl, CellDoc-Nano-B_Mask.gbs, CellDoc-Nano-B_Paste.gbp, CellDoc-Nano-B_Silkscreen.gbo, CellDoc-Nano-Edge_Cuts.gm1, CellDoc-Nano-F_Cu.gtl, CellDoc-Nano-F_Mask.gts, CellDoc-Nano-F_Paste.gtp]
2026-10-28 Nano-Platine: Werte von R, Q und C1 im Bestueckungsdruck
    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
    [CellDoc-Nano-B_Cu.gbl, CellDoc-Nano-B_Mask.gbs, CellDoc-Nano-B_Paste.gbp, CellDoc-Nano-B_Silkscreen.gbo, CellDoc-Nano-Edge_Cuts.gm1, CellDoc-Nano-F_Cu.gtl, CellDoc-Nano-F_Mask.gts, CellDoc-Nano-F_Paste.gtp]
2026-10-28 Nano-Platine: Beschriftung Q3/Q4 versetzt
    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
    [CellDoc-Nano-B_Cu.gbl, CellDoc-Nano-B_Mask.gbs, CellDoc-Nano-B_Paste.gbp, CellDoc-Nano-B_Silkscreen.gbo, CellDoc-Nano-Edge_Cuts.gm1, CellDoc-Nano-F_Cu.gtl, CellDoc-Nano-F_Mask.gts, CellDoc-Nano-F_Paste.gtp]
2026-10-28 Nano-Platine: Beschriftung Q4 versetzt
    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
    [CellDoc-Nano-B_Cu.gbl, CellDoc-Nano-B_Mask.gbs, CellDoc-Nano-B_Paste.gbp, CellDoc-Nano-B_Silkscreen.gbo, CellDoc-Nano-Edge_Cuts.gm1, CellDoc-Nano-F_Cu.gtl, CellDoc-Nano-F_Mask.gts, CellDoc-Nano-F_Paste.gtp]
2026-10-28 Nano-Platine: Beschriftung OLED und QR-Scanner
    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
    [CellDoc-Nano-B_Cu.gbl, CellDoc-Nano-B_Mask.gbs, CellDoc-Nano-B_Paste.gbp, CellDoc-Nano-B_Silkscreen.gbo, CellDoc-Nano-Edge_Cuts.gm1, CellDoc-Nano-F_Cu.gtl, CellDoc-Nano-F_Mask.gts, CellDoc-Nano-F_Paste.gtp]
2026-10-29 WLAN-Einrichtung direkt im Webflasher (Improv Serial)
    Nach dem Flashen bietet der Webflasher „Connect to Wi-Fi“ an, später
    „Change Wi-Fi“ ohne neu zu flashen. Gilt für alle Geräte und Boards.
    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
